DiogoJKoike/B152B/BioPrinter_Schematics/Drill.pdf

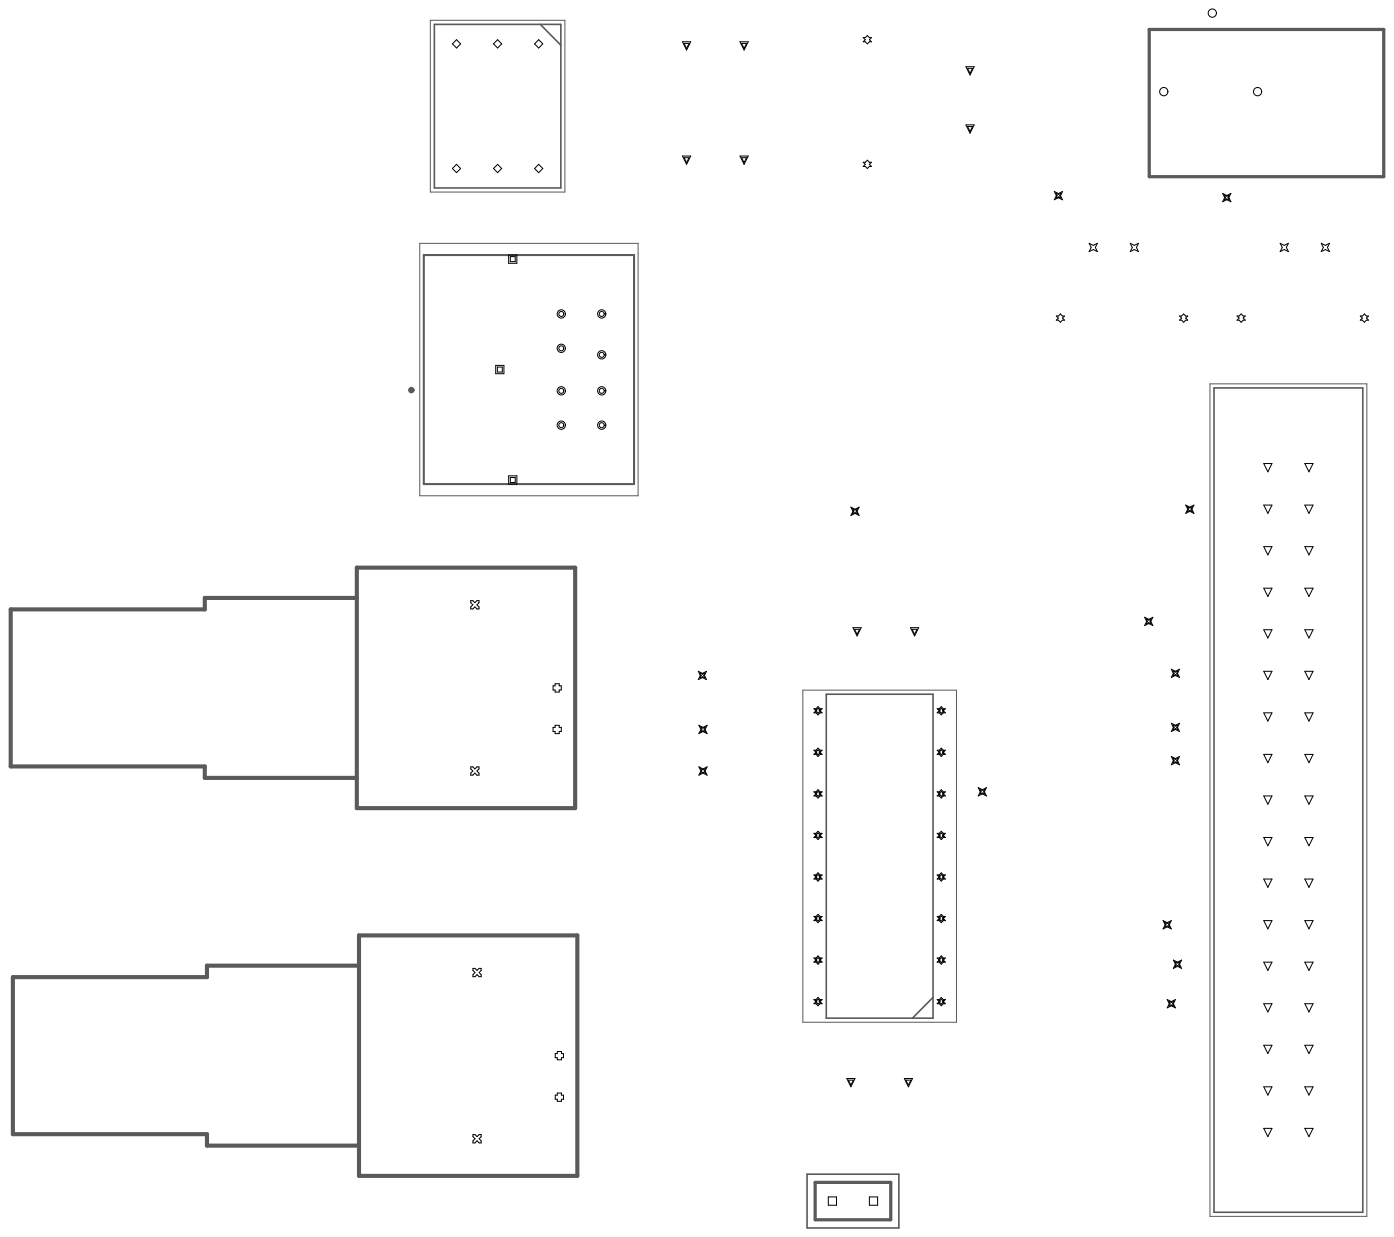
[picture p33: page 1]
