DiogoJKoike/B152B/(list of files, drawings)

Other design files:
BioPrinter_Schematics/BioPrinter_Schematics.PcbDoc
BioPrinter_Schematics/BioPrinter_Schematics.PcbLib
BioPrinter_Schematics/BioPrinter_Schematics.PrjPcb
BioPrinter_Schematics/BioPrinter_Schematics.SchDoc
BioPrinter_Schematics/BioPrinter_Schematics.SchLib
